DranzerZERogue56/disc-golf-snap-trainer/preview_34.png

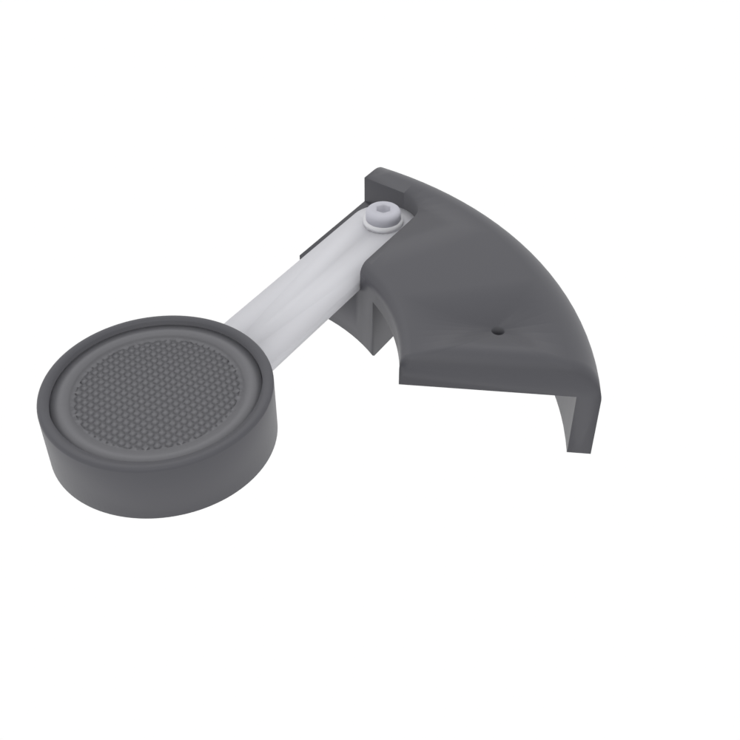
preview_34.png
