DranzerZERogue56/disc-golf-snap-trainer/preview_exploded.png

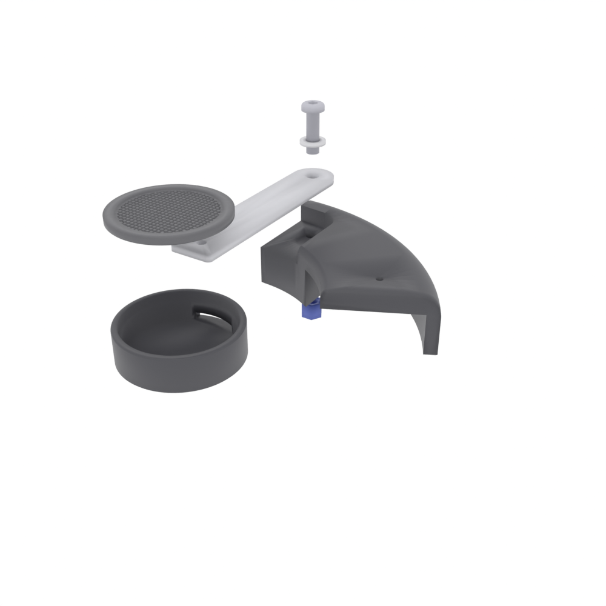
preview_exploded.png
