DranzerZERogue56/disc-golf-snap-trainer/preview_grip_lip.png

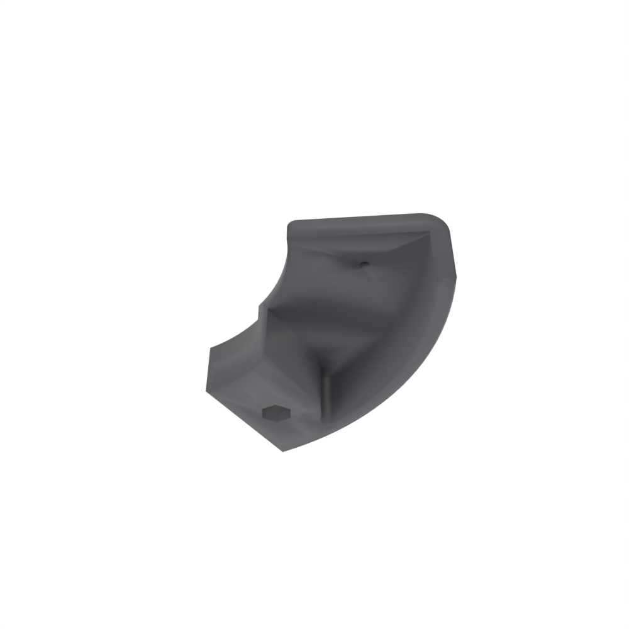
preview_grip_lip.png
