DranzerZERogue56/disc-golf-snap-trainer/preview_grip_section.png

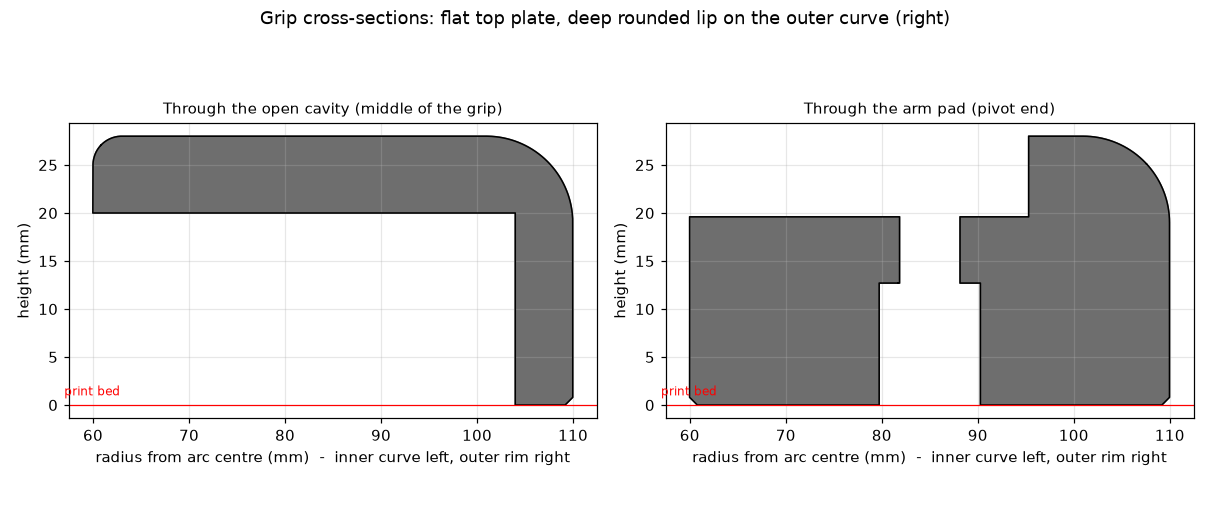
preview_grip_section.png
