DranzerZERogue56/disc-golf-snap-trainer/preview_grip_underside.png

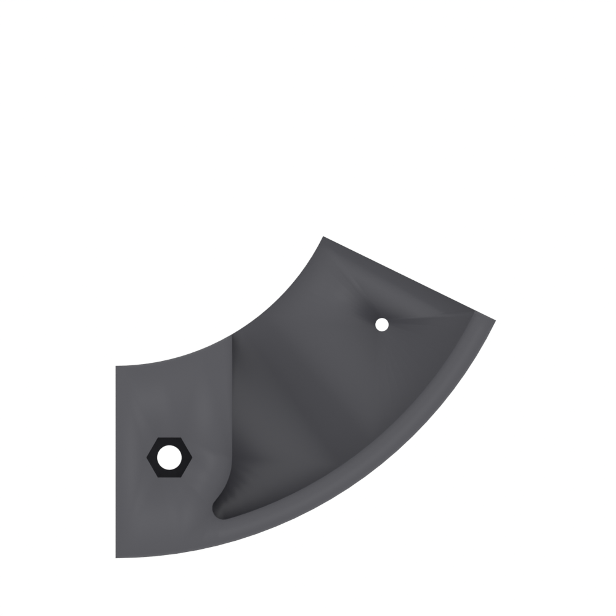
preview_grip_underside.png
