DranzerZERogue56/disc-golf-snap-trainer/preview_swing_range.png

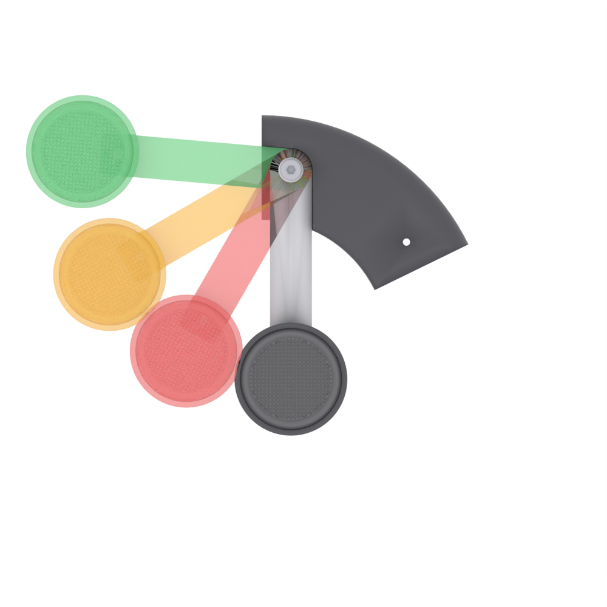
preview_swing_range.png
