DranzerZERogue56/disc-golf-snap-trainer/preview_top.png

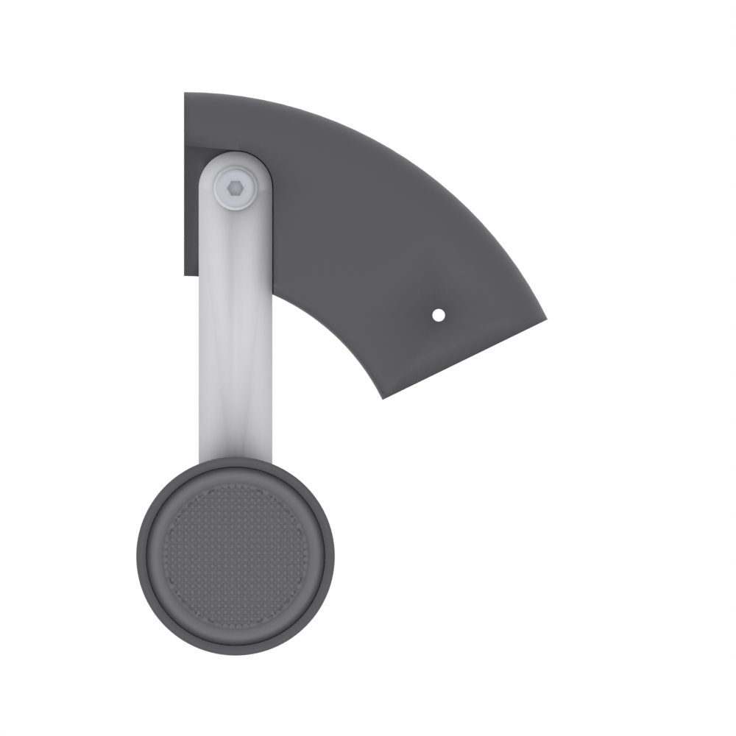
preview_top.png
