DranzerZERogue56/disc-golf-snap-trainer/trainer_assembly.step

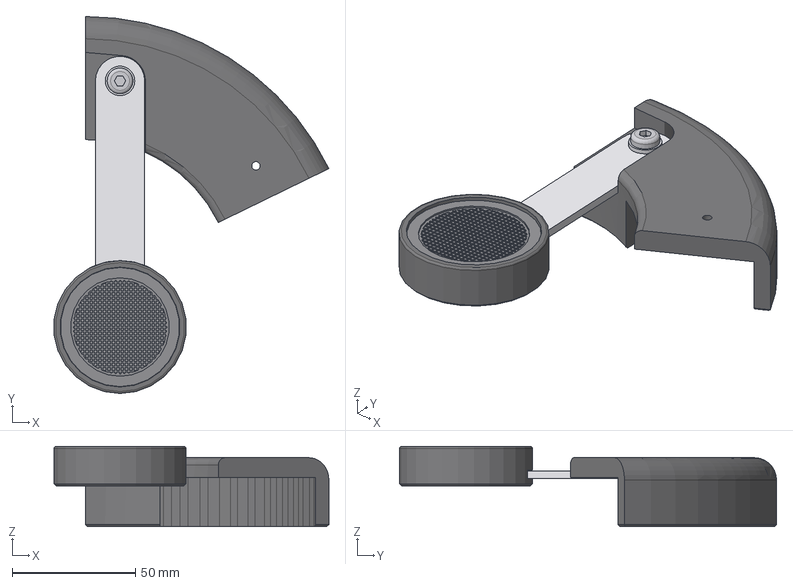
[picture p8: CAD file, 2026-11-05]
trainer_assembly.step
111.7 x 153.2 x 32.6 mm
grip
arm
weight_cup
weight_lid
bolt
washer
nut
