DranzerZERogue56/disc-golf-snap-trainer/grip.stl

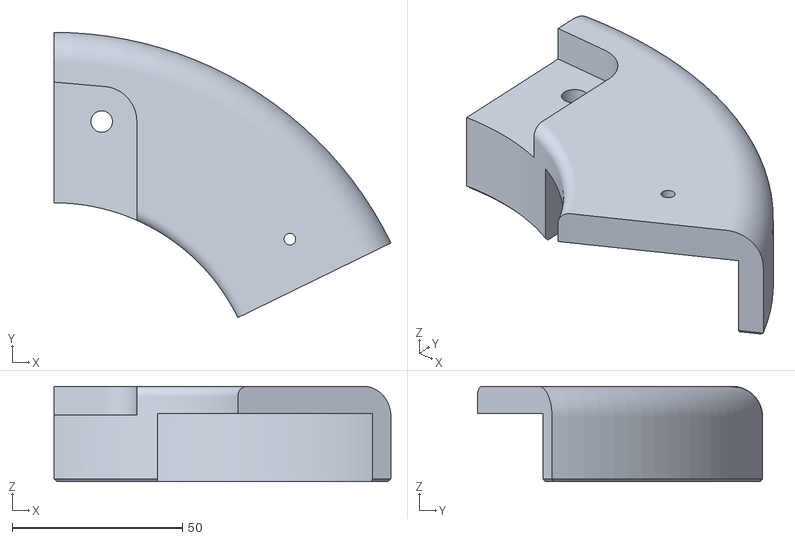
[picture p9: CAD file, 2026-11-05]
grip.stl
98.9 x 83.7 x 28.0
