DranzerZERogue56/disc-golf-snap-trainer/weight_for_printed_arm.stl

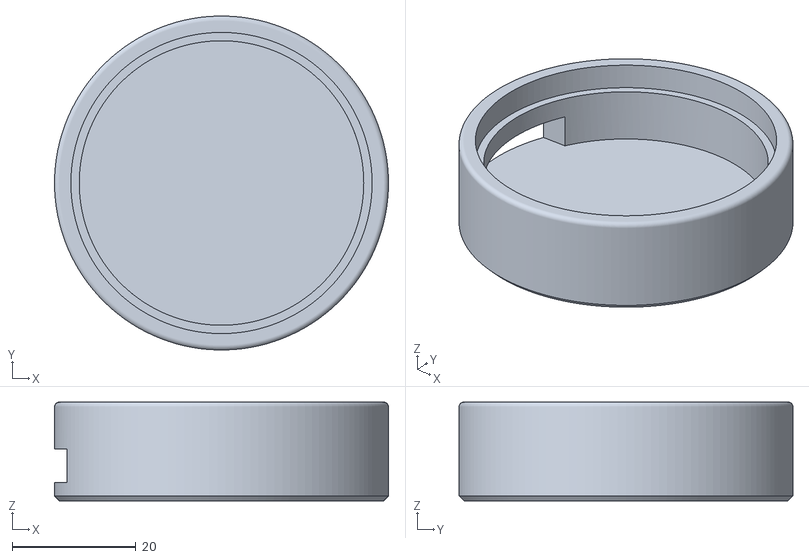
[picture p10: CAD file, 2026-11-04]
weight_for_printed_arm.stl
54.0 x 54.0 x 16.0
