DranzerZERogue56/disc-golf-snap-trainer/weight_lid.stl

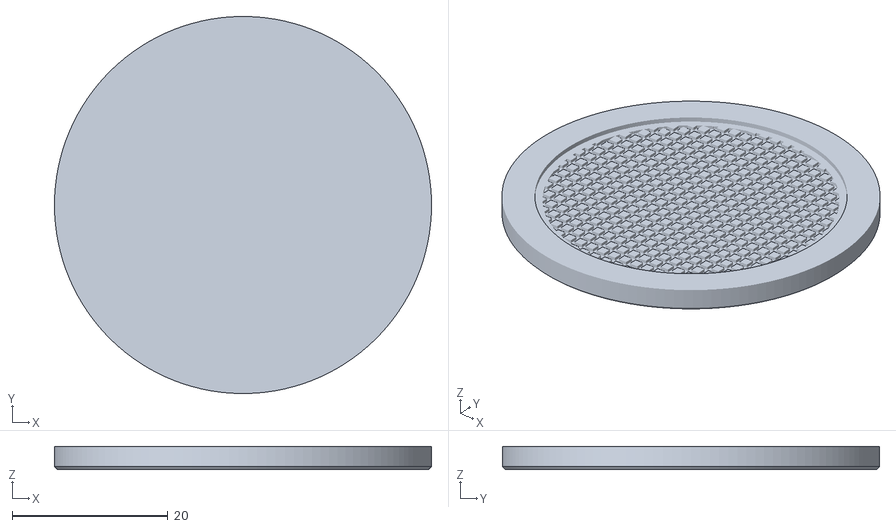
[picture p11: CAD file, 2026-11-04]
weight_lid.stl
48.4 x 48.4 x 3.00
