DranzerZERogue56/disc-golf-snap-trainer/arm_printed.stl

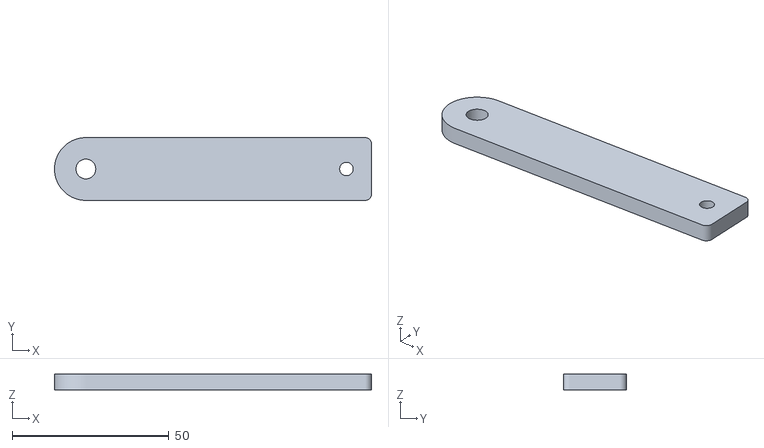
[picture p12: CAD file, 2026-11-04]
arm_printed.stl
101.0 x 20.0 x 5.00
