DranzerZERogue56/disc-golf-snap-trainer/(list of files, cad)

Other CAD files:
grip_for_printed_arm.stl
weight.stl
trainer_assembly.3mf
