DranzerZERogue56/disc-golf-snap-trainer/arm_steel_drawing.pdf

# SNAP TRAINER - STEEL ARM (cut from flat bar)

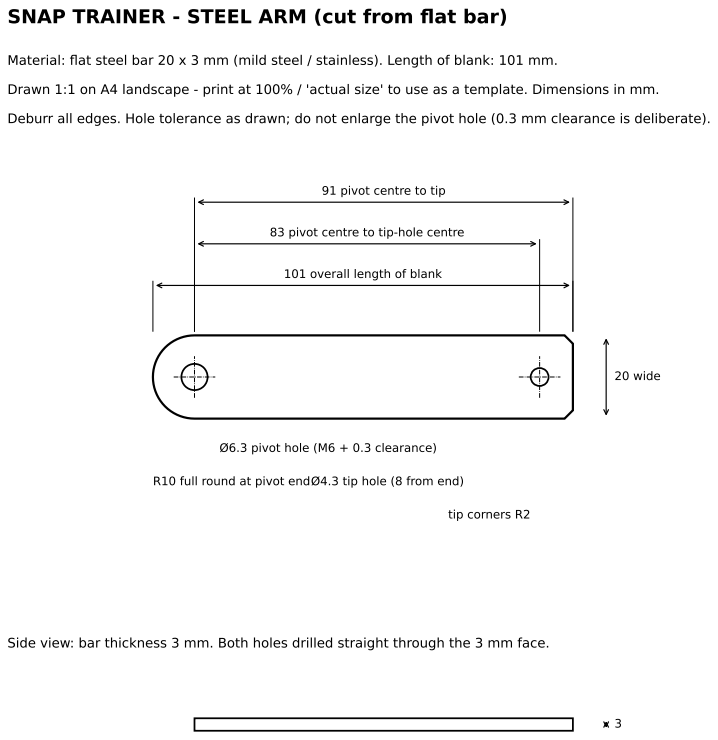
[picture p13: page 1]
20 wide; tip corners R2

Material: flat steel bar 20 x 3 mm (mild steel / stainless). Length of blank: 101 mm.

Drawn 1:1 on A4 landscape - print at 100% / 'actual size' to use as a template. Dimensions in mm.

Deburr all edges. Hole tolerance as drawn; do not enlarge the pivot hole (0.3 mm clearance is deliberate).

91 pivot centre to tip

83 pivot centre to tip-hole centre

101 overall length of blank

Ø6.3 pivot hole (M6 + 0.3 clearance)

R10 full round at pivot endØ4.3 tip hole (8 from end)

Side view: bar thickness 3 mm. Both holes drilled straight through the 3 mm face.
