DranzerZERogue56/disc-golf-snap-trainer/(commit log)

2026-11-04 Disc golf snap wrist trainer: parametric CadQuery model, STLs, STEP/3MF, docs
    [arm_printed.stl, grip.stl, grip_for_printed_arm.stl, trainer_assembly.3mf, trainer_assembly.step, weight.stl, weight_for_printed_arm.stl, weight_lid.stl]
2026-11-05 Hollow underside for the grip: thin shell with ribs and bosses instead of a solid block
    [grip.stl, grip_for_printed_arm.stl, trainer_assembly.3mf, trainer_assembly.step]
2026-11-05 Disc-style grip: flat top plate, deep rounded lip on the outer curve, open underside, solid arm pad
    [grip.stl, grip_for_printed_arm.stl, trainer_assembly.3mf, trainer_assembly.step]
